LucasLiuXinqi/RUKA-V2-Assembly-Instruction/docs/SUMMARY.md

# Table of contents

* [Home](README.md)
* [Hardware Overview](introduction.md)
* [Bill of Materials](bom.md)
* [CAD Files](cad-files.md)

## Assembly

* [Overview](assembly/index.md)
* [Step 01 — Heat Insert Tutorial](assembly/step-01-palm.md)
* [Step 02 — Finger Assembly](assembly/step-02-fingers.md)
* [Step 03 — Knuckle Assembly](assembly/step-03-tendons.md)
* [Step 04 — Palm Assembly](assembly/step-04-wrist.md)
* [Step 05 — Wrist Assembly](assembly/step-05-final.md)
* [Step 06 — Wiring and Motor IDs](assembly/step-06-wiring-and-motor-ids.md)
* [Step 07 — Motor Base Assembly](assembly/step-07-motor-base-assembly.md)
* [Step 08 — Attach Wrist and Motor Base](assembly/step-08-attach-wrist-and-motor-base.md)
* [Step 09 — Mount Pulleys](assembly/step-09-mount-pulleys.md)
* [Step 10 — Robot Arm Mount](assembly/step-10-robot-arm-mount.md)

## Software

* [Calibration](software/motion-check.md)
