LucasLiuXinqi/RUKA-V2-Assembly-Instruction/docs/cad-files.md

---
icon: file-cad
---

# CAD Files

### Complete CAD File

put link here

### Download and print parts

Plate STLs

<table><thead><tr><th width="259.3046875">Print Setting</th><th>Right Hand</th><th>Left Hand</th></tr></thead><tbody><tr><td>100% infill, 0.2mm layer height</td><td></td><td></td></tr><tr><td>50% infill, 0.2mm layer height</td><td></td><td></td></tr><tr><td>100% infill, 0.2mm layer height</td><td></td><td></td></tr><tr><td>100% infill, 0.2mm layer height</td><td></td><td></td></tr><tr><td>30% infill, 0.2mm layer height</td><td></td><td></td></tr><tr><td>100% infill, 0.2mm layer height</td><td></td><td></td></tr><tr><td>100% infill, 0.2mm layer height</td><td></td><td></td></tr></tbody></table>

### Finger Tip Replacements

| Print Setting | Files |
| --- | --- |
| |  |
| |  |
| |  |
