LucasLiuXinqi/RUKA-V2-Assembly-Instruction/docs/introduction.md

---
icon: robot-astromech
---

# Hardware Overview

### What do I need to buy?

{% content-ref url="bom.md" %}
[bom.md](bom.md)
{% endcontent-ref %}

### What do I need to print?

{% content-ref url="cad-files.md" %}
[cad-files.md](cad-files.md)
{% endcontent-ref %}

### How can I build one?

{% content-ref url="/broken/pages/gg4XZXHeW4K00vUBnZCy" %}
[Broken link](/broken/pages/gg4XZXHeW4K00vUBnZCy)
{% endcontent-ref %}
