LucasLiuXinqi/RUKA-V2-Assembly-Instruction/docs/bom.md

---
icon: sack-dollar
---

# Bill of Materials

<table><thead><tr><th width="252.07421875">Name</th><th>URL</th><th width="100">Quantity</th></tr></thead><tbody><tr><td>Tendons: Braided Fishing Line (0.75mm or 0.68mm)</td><td><a href="https://www.amazon.com/dp/B076HJ3VS5?social_share=cm_sw_r_cp_ud_dp_24VJYD9PYNSQ9QNX9VNS&#x26;previewDoh=1">https://www.amazon.com/dp/B076HJ3VS5?social_share=cm_sw_r_cp_ud_dp_24VJYD9PYNSQ9QNX9VNS&#x26;previewDoh=1</a></td><td>1</td></tr><tr><td>PTFE Tubing 2mm ID, 4mm OD (5 ft)</td><td><a href="https://www.google.com/url?q=https://www.mcmaster.com/52335K32/&#x26;sa=D&#x26;source=editors&#x26;ust=1770211511896520&#x26;usg=AOvVaw31-wdlbmtokcd7ZWvv9eOh">https://www.google.com/url?q=https://www.mcmaster.com/52335K32/&#x26;sa=D&#x26;source=editors&#x26;ust=1770211511896520&#x26;usg=AOvVaw31-wdlbmtokcd7ZWvv9eOh</a></td><td>1</td></tr><tr><td>Bambu Matte Black Filament</td><td><a href="https://www.google.com/url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;sa=D&#x26;source=editors&#x26;ust=1770211511897782&#x26;usg=AOvVaw3Xr1db1b0BrXV-5jqtFpiD">https://www.google.com/url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;sa=D&#x26;source=editors&#x26;ust=1770211511897782&#x26;usg=AOvVaw3Xr1db1b0BrXV-5jqtFpiD</a></td><td>1</td></tr><tr><td>16 mm Dowel Pins (50 pk)</td><td><a href="https://www.google.com/url?q=https://www.mcmaster.com/91585A304/&#x26;sa=D&#x26;source=editors&#x26;ust=1770211511900546&#x26;usg=AOvVaw1xtzFYYHmhV-85Eanl925z">https://www.google.com/url?q=https://www.mcmaster.com/91585A304/&#x26;sa=D&#x26;source=editors&#x26;ust=1770211511900546&#x26;usg=AOvVaw1xtzFYYHmhV-85Eanl925z</a></td><td>1</td></tr><tr><td>M2/3/4/5 Srew Set</td><td><a href="https://www.google.com/url?q=https://a.co/d/elxrhl5&#x26;sa=D&#x26;source=editors&#x26;ust=1770211511901753&#x26;usg=AOvVaw3hGCDJwOGZF84YwLuHKkzG">https://www.google.com/url?q=https://a.co/d/elxrhl5&#x26;sa=D&#x26;source=editors&#x26;ust=1770211511901753&#x26;usg=AOvVaw3hGCDJwOGZF84YwLuHKkzG</a></td><td>1</td></tr><tr><td>Torsion Spring, Left-Hand Wind (6 pk)</td><td><a href="https://www.google.com/url?q=https://www.mcmaster.com/9271K177/&#x26;sa=D&#x26;source=editors&#x26;ust=1770211511902859&#x26;usg=AOvVaw0EKswpu569-A0xXOycgV93">https://www.google.com/url?q=https://www.mcmaster.com/9271K177/&#x26;sa=D&#x26;source=editors&#x26;ust=1770211511902859&#x26;usg=AOvVaw0EKswpu569-A0xXOycgV93</a></td><td>1</td></tr><tr><td>Extension Springs 0.016"x0.16"x0.59" (5 pk)</td><td><a href="https://www.amazon.com/METALLIXITY-Extension-0-4x4x15mm-Stainless-Tension/dp/B0BRHFPGDM?sr=1-1">https://www.amazon.com/METALLIXITY-Extension-0-4x4x15mm-Stainless-Tension/dp/B0BRHFPGDM?sr=1-1</a></td><td>3</td></tr><tr><td>Extension Springs 0.016"x0.16"x0.79" (5 pk)</td><td><a href="https://www.amazon.com/METALLIXITY-Extension-0-4x4x15mm-Stainless-Tension/dp/B0BRHFJ33V?sr=1-1">https://www.amazon.com/METALLIXITY-Extension-0-4x4x15mm-Stainless-Tension/dp/B0BRHFJ33V?sr=1-1</a></td><td>1</td></tr><tr><td>Brass Insert Variety Pack</td><td><a href="https://www.amazon.com/dp/B08YYGRCBG?starsLeft=1">https://www.amazon.com/dp/B08YYGRCBG?starsLeft=1</a></td><td>1</td></tr><tr><td>M2*2 Insert</td><td><a href="https://www.amazon.com/Pofsnnx-Components-Classification-Combination-M2xL2xD3-2/dp/B0FJXLNMLM?sr=1-3">https://www.amazon.com/Pofsnnx-Components-Classification-Combination-M2xL2xD3-2/dp/B0FJXLNMLM?sr=1-3</a></td><td>1</td></tr><tr><td>Bearings 2.5mm Inner Dia 6mm OD 2.6mm</td><td><a href="https://www.amazon.com/uxcell-682XZZ-Groove-Bearings-Shielded/dp/B082PX3KX9?sr=8-8&#x26;th=1">https://www.amazon.com/uxcell-682XZZ-Groove-Bearings-Shielded/dp/B082PX3KX9?sr=8-8&#x26;th=1</a></td><td>4</td></tr><tr><td>Bearings 5mm Inner Dia 10mm OD 4mm</td><td><a href="https://www.amazon.com/uxcell-MR105-2RS-Groove-Bearings-Double/dp/B082PS3QDJ?sr=8-5">https://www.amazon.com/uxcell-MR105-2RS-Groove-Bearings-Double/dp/B082PS3QDJ?sr=8-5</a></td><td>1</td></tr><tr><td>M5 Lock Nuts</td><td><a href="https://www.amazon.com/PDETVEO-50PCS-Stainless-M5-0-8-Insert/dp/B0D8THJQNM?sr=8-7">https://www.amazon.com/PDETVEO-50PCS-Stainless-M5-0-8-Insert/dp/B0D8THJQNM?sr=8-7</a></td><td>1</td></tr><tr><td>DYNAMIXEL XL330-M288-T</td><td><a href="https://www.robotis.us/dynamixel-xl330-m288-t/">https://www.robotis.us/dynamixel-xl330-m288-t/</a></td><td>11</td></tr><tr><td>DYNAMIXEL XM430-W210-R</td><td><a href="https://robotis.us/dynamixel-xm430-w210-r/?searchid=212368&#x26;search_query=XM430">https://robotis.us/dynamixel-xm430-w210-r/?searchid=212368&#x26;search_query=XM430</a></td><td>2</td></tr><tr><td>DYNAMIXEL XL430-W250-T</td><td><a href="https://robotis.us/dynamixel-xl430-w250-t/?searchid=212370&#x26;search_query=XL430">https://robotis.us/dynamixel-xl430-w250-t/?searchid=212370&#x26;search_query=XL430</a></td><td>3</td></tr><tr><td>U2D2</td><td><a href="https://www.google.com/url?q=https://www.robotis.us/u2d2/&#x26;sa=D&#x26;source=editors&#x26;ust=1770211511909171&#x26;usg=AOvVaw3GSwC8QKqZ7f6Z-GA2svD5">https://www.google.com/url?q=https://www.robotis.us/u2d2/&#x26;sa=D&#x26;source=editors&#x26;ust=1770211511909171&#x26;usg=AOvVaw3GSwC8QKqZ7f6Z-GA2svD5</a></td><td>1</td></tr><tr><td>12V 5V Power Supply</td><td></td><td>1</td></tr><tr><td>Power Cable</td><td><a href="https://www.google.com/url?q=https://a.co/d/74DwkBz&#x26;sa=D&#x26;source=editors&#x26;ust=1770211511913021&#x26;usg=AOvVaw0vcJ2DKXe4MsHar7cwwOg-">https://www.google.com/url?q=https://a.co/d/74DwkBz&#x26;sa=D&#x26;source=editors&#x26;ust=1770211511913021&#x26;usg=AOvVaw0vcJ2DKXe4MsHar7cwwOg-</a></td><td>1</td></tr><tr><td>XT60 Connector Pairs</td><td></td><td></td></tr><tr><td></td><td></td><td></td></tr></tbody></table>

### **Required Tools**

* 3D Printer
* Soldering Iron
* Allen Keys (M2, M3, M5)
* Tweezers
* Pliers

### Optional (but suggested) Tools

* Sandpaper
* Drill and drill bits
* Soldering tips for brass inserts
