LucasLiuXinqi/RUKA-V2-Assembly-Instruction/docs/.gitbook/assets/FingertipSocket.stl

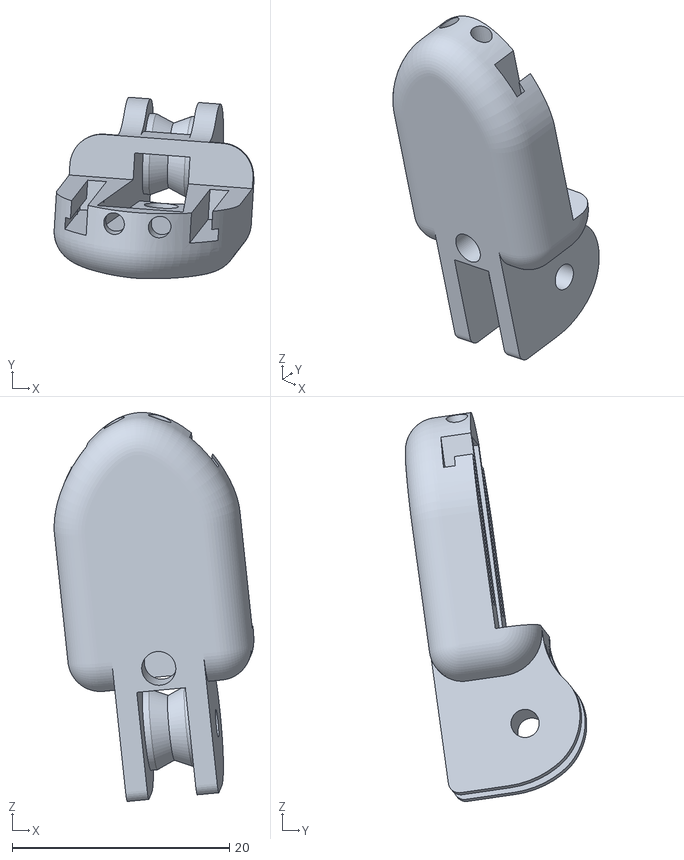
[picture p1: CAD file, 2026-03-08]
docs/.gitbook/assets/FingertipSocket.stl
18.4 x 16.7 x 35.8
