LucasLiuXinqi/RUKA-V2-Assembly-Instruction/docs/.gitbook/assets/AllFingertipButThumb.3mf

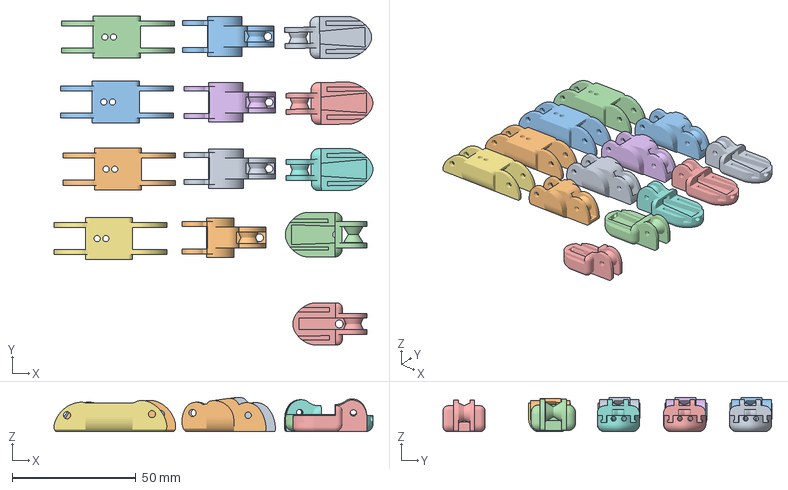
[picture p2: CAD file, 2026-03-08]
docs/.gitbook/assets/AllFingertipButThumb.3mf
129.0 x 133.0 x 13.9 mm
FingertipSocket.stl x 3
RukaV2PinkyPIPTolerance.stl
RukaV2IndexPIPTolerance.stl x 3
RukaV2IndexMCPTolerance.stl x 4
ThumbSocket.stl
PinkySocket.stl
