LucasLiuXinqi/RUKA-V2-Assembly-Instruction/docs/.gitbook/assets/Base_Left.stl

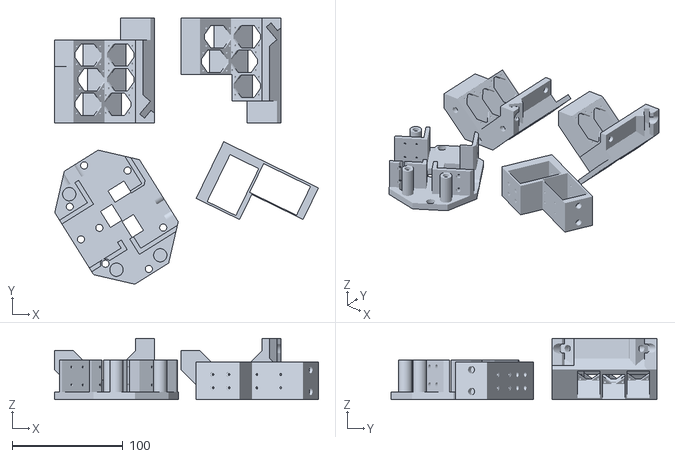
[picture p3: CAD file, 2026-03-03]
docs/.gitbook/assets/Base_Left.stl
237.9 x 240.1 x 55.0
