LucasLiuXinqi/RUKA-V2-Assembly-Instruction/docs/.gitbook/assets/Wrist_Left.stl

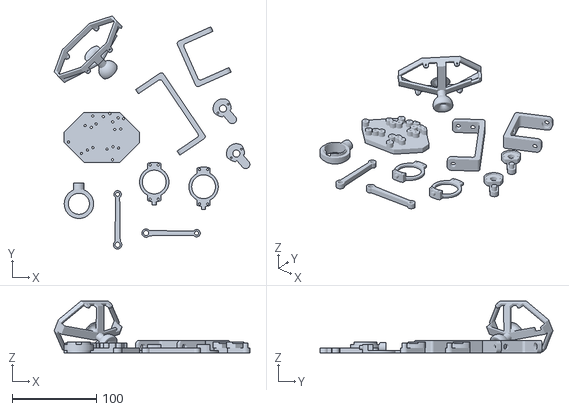
[picture p4: CAD file, 2026-03-03]
docs/.gitbook/assets/Wrist_Left.stl
232.7 x 277.0 x 61.7
