LucasLiuXinqi/RUKA-V2-Assembly-Instruction/docs/.gitbook/assets/Wrist_Base_Left.stl

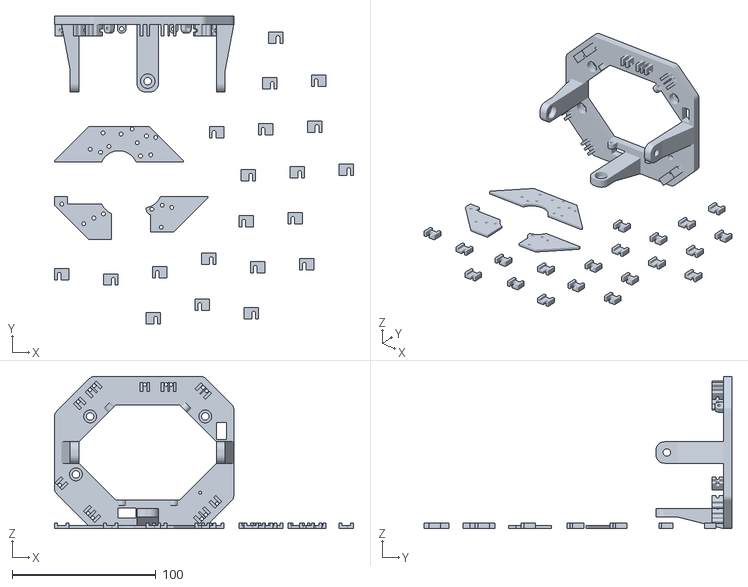
[picture p5: CAD file, 2026-03-03]
docs/.gitbook/assets/Wrist_Base_Left.stl
208.4 x 214.6 x 106.0
