LucasLiuXinqi/RUKA-V2-Assembly-Instruction/docs/.gitbook/assets/Palm_Left.stl

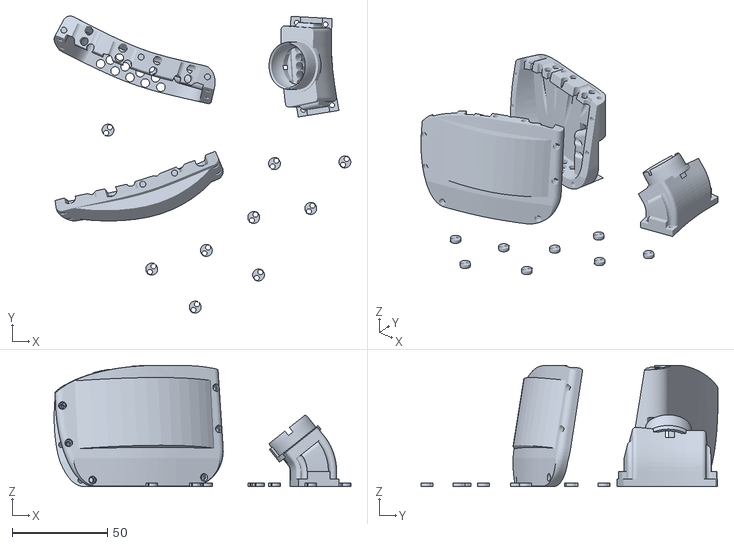
[picture p6: CAD file, 2026-03-03]
docs/.gitbook/assets/Palm_Left.stl
155.5 x 155.6 x 63.5
