LucasLiuXinqi/RUKA-V2-Assembly-Instruction/docs/.gitbook/assets/Arm_Connector (1).stl

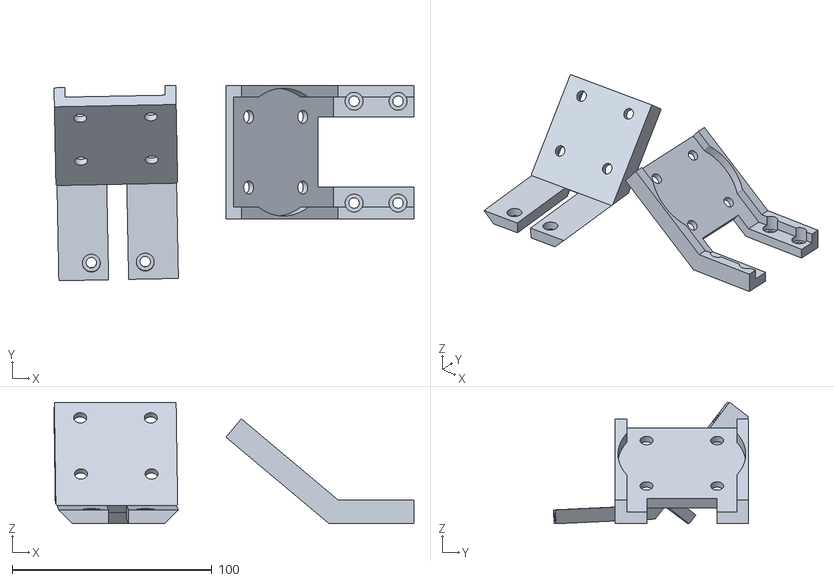
[picture p7: CAD file, 2026-03-03]
docs/.gitbook/assets/Arm_Connector (1).stl
180.3 x 97.9 x 60.8
