LucasLiuXinqi/RUKA-V2-Assembly-Instruction/(list of files, cad)

Other CAD files:
docs/.gitbook/assets/Palm.stl
docs/.gitbook/assets/Wrist_Base.stl
docs/.gitbook/assets/Base.stl
docs/.gitbook/assets/Wrist.stl
