LucasLiuXinqi/RUKA-V2-Assembly-Instruction/docs/assembly/step-09-mount-pulleys.md

# Step 09 — Mount Pulleys

<table><thead><tr><th width="212.91796875">Part Name</th><th width="120.76171875">Quantity</th></tr></thead><tbody><tr><td>Small Pulleys</td><td>11</td></tr><tr><td>Large Pulleys</td><td>3</td></tr><tr><td>6mm Dynamixel screws*</td><td>22</td></tr><tr><td>M2 x 4 mm Screws</td><td>6</td></tr></tbody></table>

\*Screws come with the Dynamixel motors

### Instructions

#### 1. Insert the string

Feed the string through the pulley\


#### 2. Loosely attach the pulley to the motor

Attach the pulley with two screws loosely such that the string can still be pulled\


#### 3. Tie the knot

Tie the knot in the string as close to the pulley as possible, then pull the string through.



#### 4. Tighten the screws all the way

Repeat this for all motors.
