LucasLiuXinqi/RUKA-V2-Assembly-Instruction/docs/assembly/step-10-robot-arm-mount.md

---
description: >-
  There are two different adapter corresponding to two different hand
  orientation.
---

# Step 10 — Robot Arm Mount

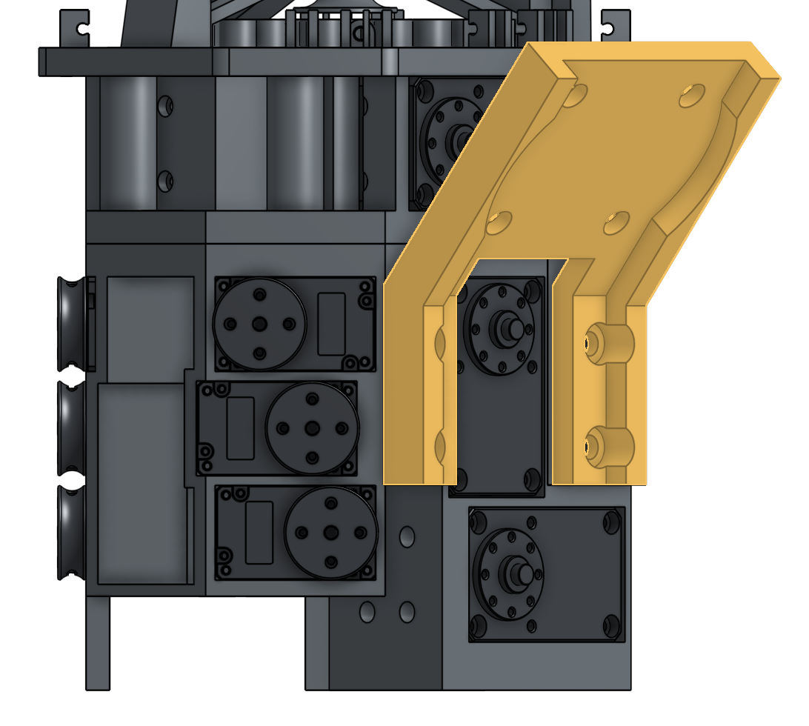
[picture p24: docs/.gitbook/assets/Screenshot 2026-03-25 at 10.56.10.png]
<figure><figcaption></figcaption></figure>

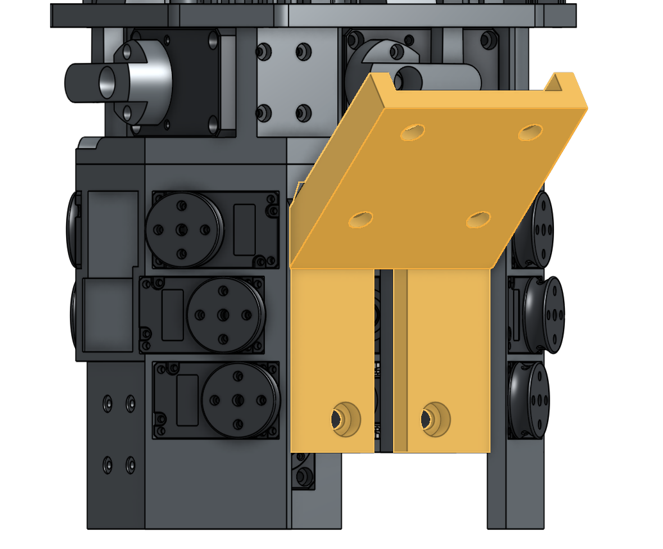
[picture p25: docs/.gitbook/assets/Screenshot 2026-03-25 at 10.56.36.png]
<figure><figcaption></figcaption></figure>
