LucasLiuXinqi/RUKA-V2-Assembly-Instruction/docs/assembly/step-05-final.md

# Step 05 — Wrist Assembly

### 1. Before Assembly

* Make sure that the ball joint is polished, and test it with the wrist connector; it should move freely.

### 2. Assembly Instruction

{% embed url="https://youtu.be/Rm0DyU4A358" %}

#### Bearings Insertion

| Required Parts | Quantity |
| --- | --- |
| Base | 1 |
| Inner Linkage | 1 |
| Outer Linkage | 1 |
| Bearings (10mm OD, 5mm Inner) | 8 |

<mark style="color:$danger;">Suggestion: Use a bench clamp if it is difficult to press in.</mark>

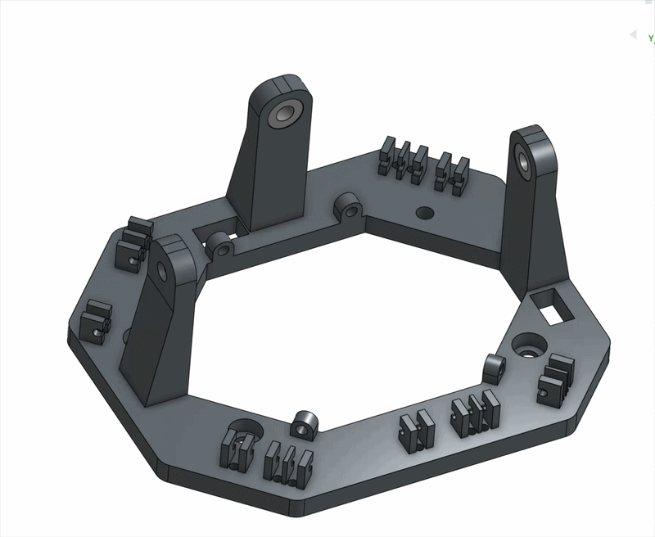
[picture p34: docs/.gitbook/assets/base (1).gif]
<figure><figcaption></figcaption></figure>

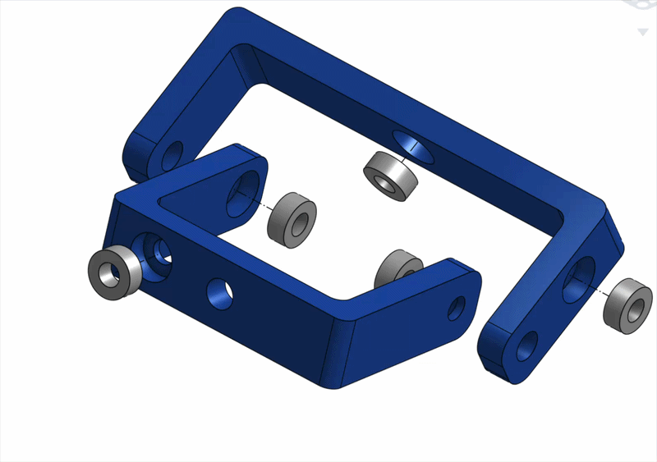
[picture p35: docs/.gitbook/assets/bearing.gif]
<figure><figcaption></figcaption></figure>

#### Wrist Assembly

| Required Parts | Quantity |
| --- | --- |
| Wrist Components | |
| M2 \* 12 Screw | 4 |
| M5 \* 20 Screw | 6 |
| M5 Washer | >8 |
| M5 Lock Nuts | 5 |

1. Press the wrist connector into the inner linkage.&#x20;

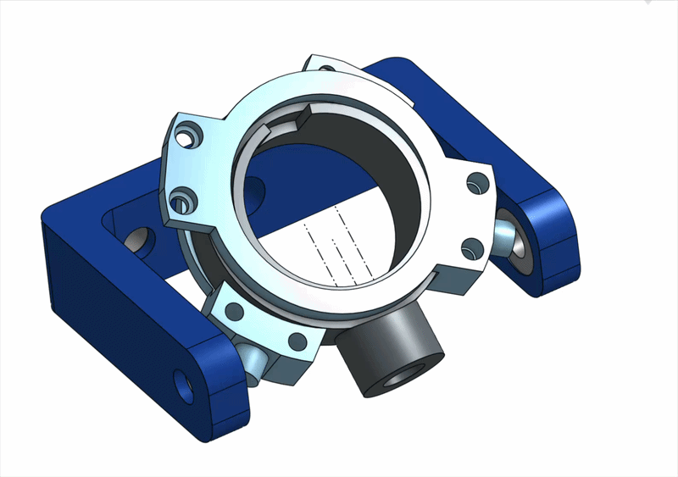
[picture p36: docs/.gitbook/assets/inner.gif]
<figure><figcaption></figcaption></figure>

2. Use four M2 \* 12 screw to fix it. <mark style="color:$danger;">CAUTION: Do not over-tighten the screws; make sure that the grey part moves freely.</mark>&#x20;

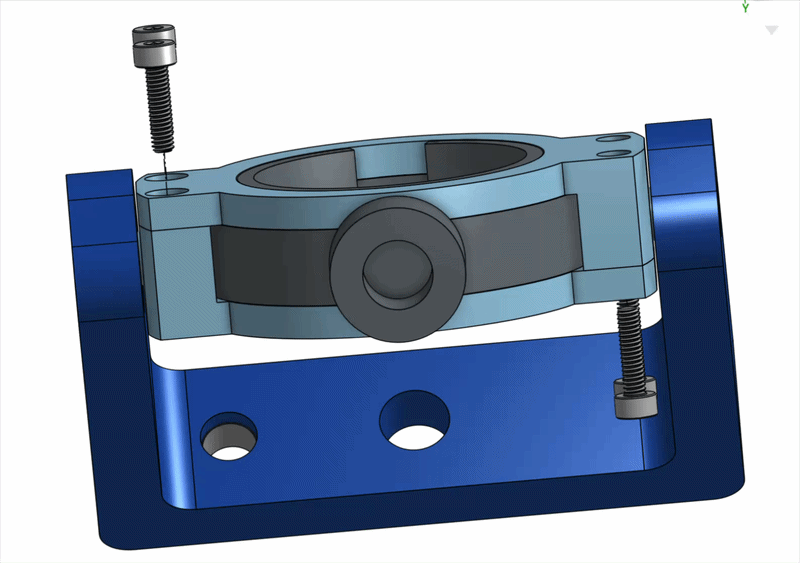
[picture p37: docs/.gitbook/assets/inner_screw.gif]
<figure><figcaption></figcaption></figure>

3. Assemble the wrist as shown below. Please refer to the assembly video for more specific steps.

<mark style="color:$danger;">Please use washers between moving parts.</mark>

<mark style="color:$danger;">Adjust the washer numbers between parts to ensure that the rotation center is at the center of the ball joint.</mark>

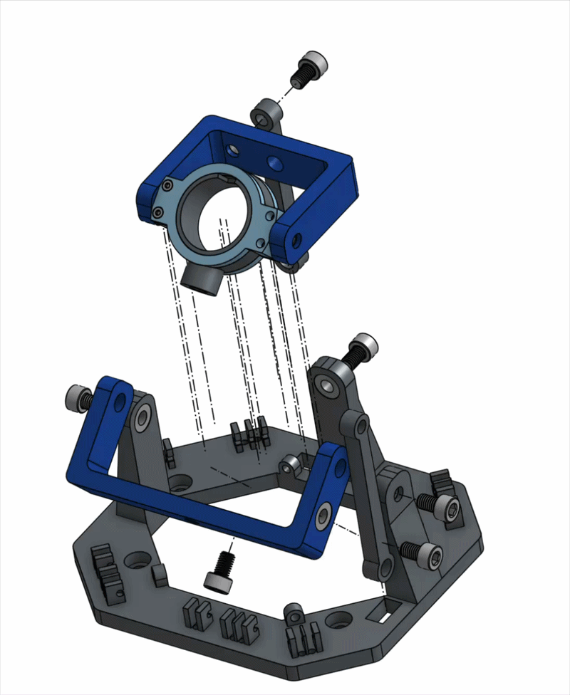
[picture p38: docs/.gitbook/assets/wrist.gif]
<figure><figcaption></figcaption></figure>

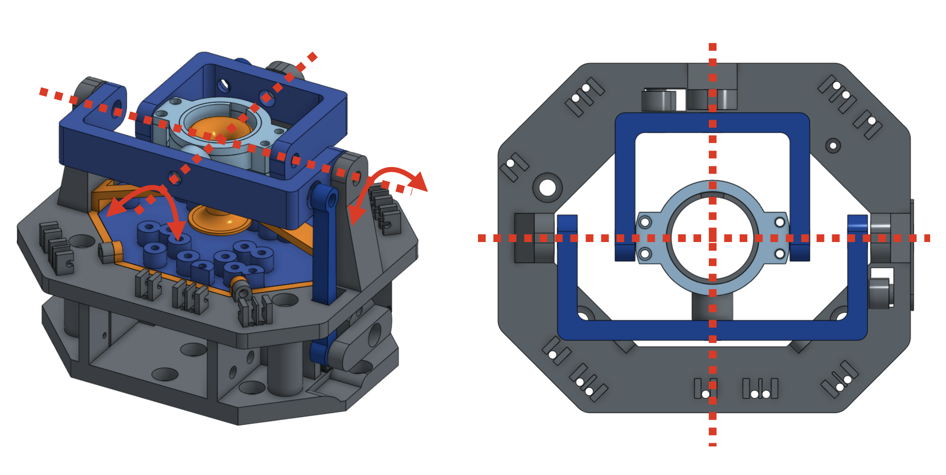
[picture p39: docs/.gitbook/assets/wrist_axis.png]
<figure><figcaption></figcaption></figure>

#### Wrist Routing

{% embed url="https://youtu.be/GrFL19Z3Onc" %}

{% embed url="https://youtu.be/DixnyVoC6T4" %}

Things to Prepare:

* Tape
* Tweezers

<mark style="color:$danger;">Things to Pay Attention:</mark>

* <mark style="color:$danger;">Make sure that the strings are not entangling with each other.</mark>
* &#x20;<mark style="color:$danger;">Verify finger movement after routing.</mark>

Steps:

1. Group and tape the strings at the wrist connector.

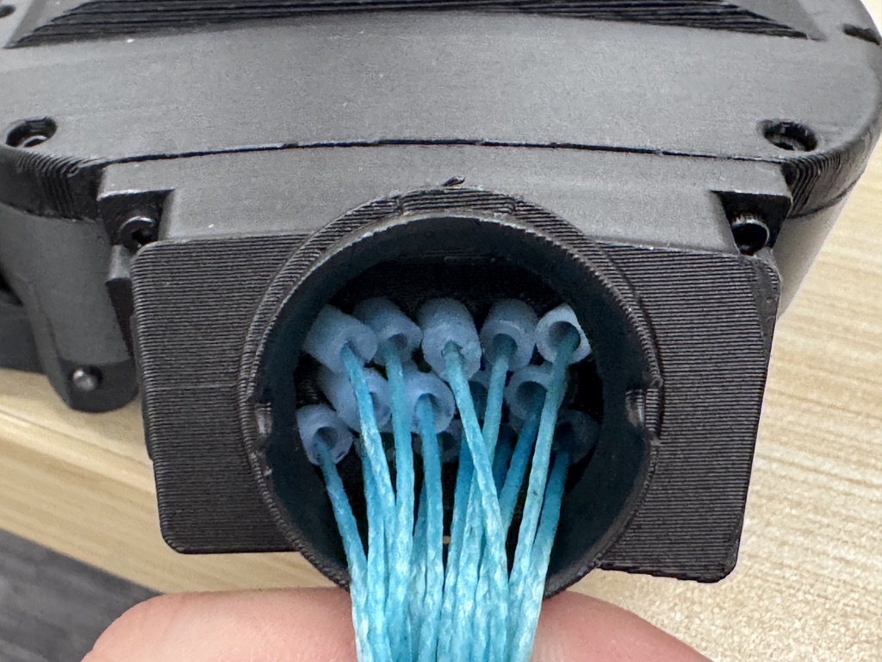
[picture p40: docs/.gitbook/assets/B8E6E3C4-9BB7-40C9-9A20-E2E0F4C1D1F8_1_105_c.jpeg]
<figure><figcaption></figcaption></figure>

2. Route the strings through the wrist group by group, and check for overlapping during the process.

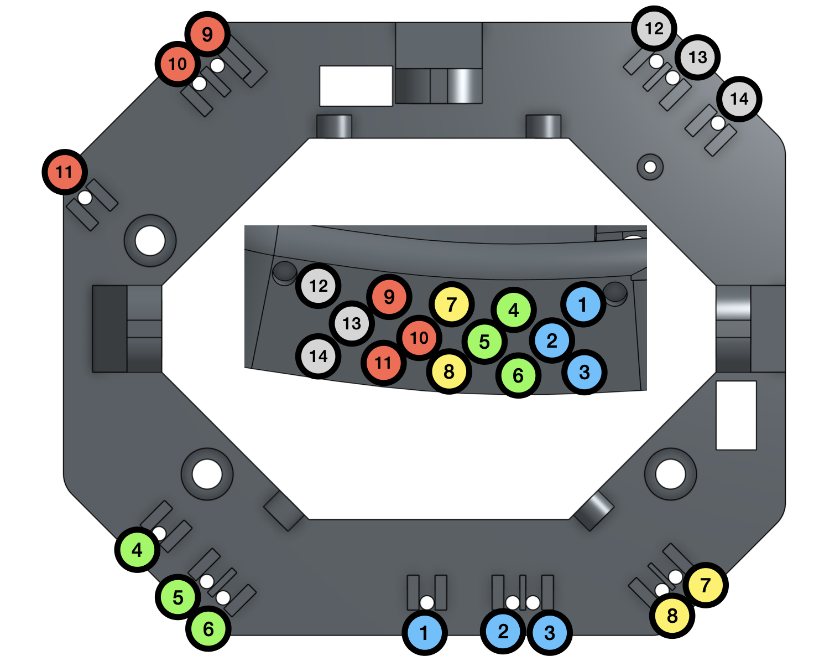
[picture p41: docs/.gitbook/assets/Screenshot 2026-03-04 at 01.11.58.png]
<figure><figcaption></figcaption></figure>

#### Bearing Plate

The printer setting may affect the dowel hole size. If you find it is extremely difficult to insert the dowel, please try re-printing the plate with a larger layer height, or use a 2.5mm drill to enlarge the hole.&#x20;

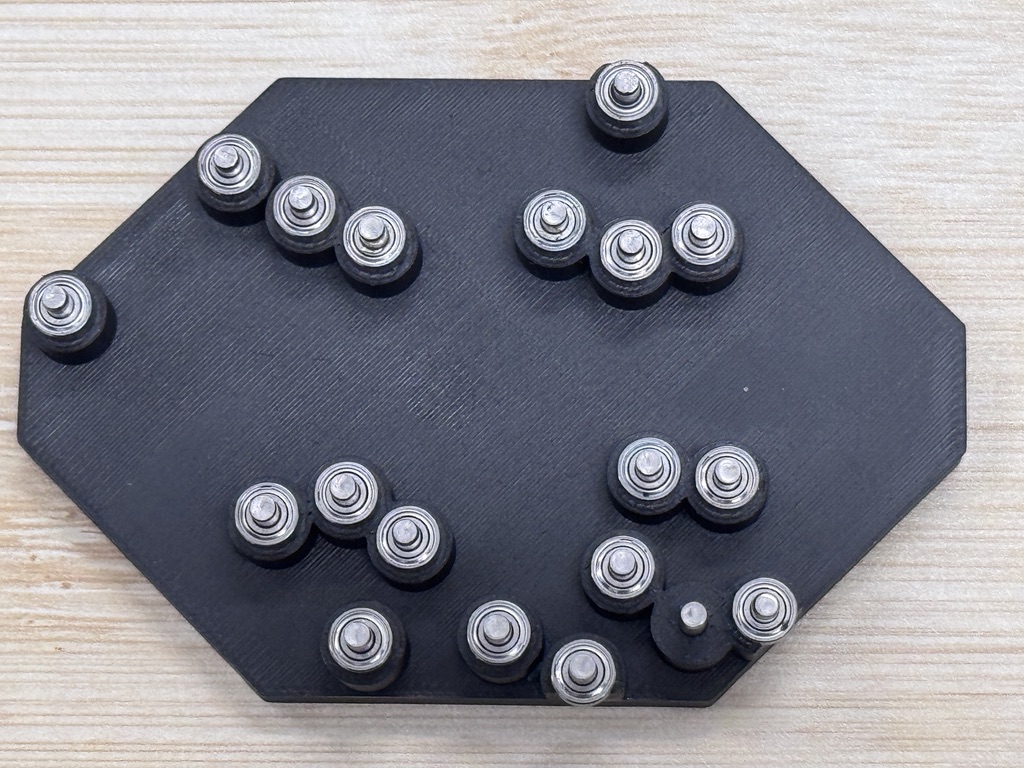
[picture p42: docs/.gitbook/assets/7B8C6E87-BC91-46EE-A5E5-320FA5DCD4B7_1_105_c.jpeg]
<figure><figcaption></figcaption></figure>

{% embed url="https://youtu.be/YHv7OPIKRvE" %}

| Ring Finger Plate | Thumb + Middle + Index | Pinky |
| --- | --- | --- |
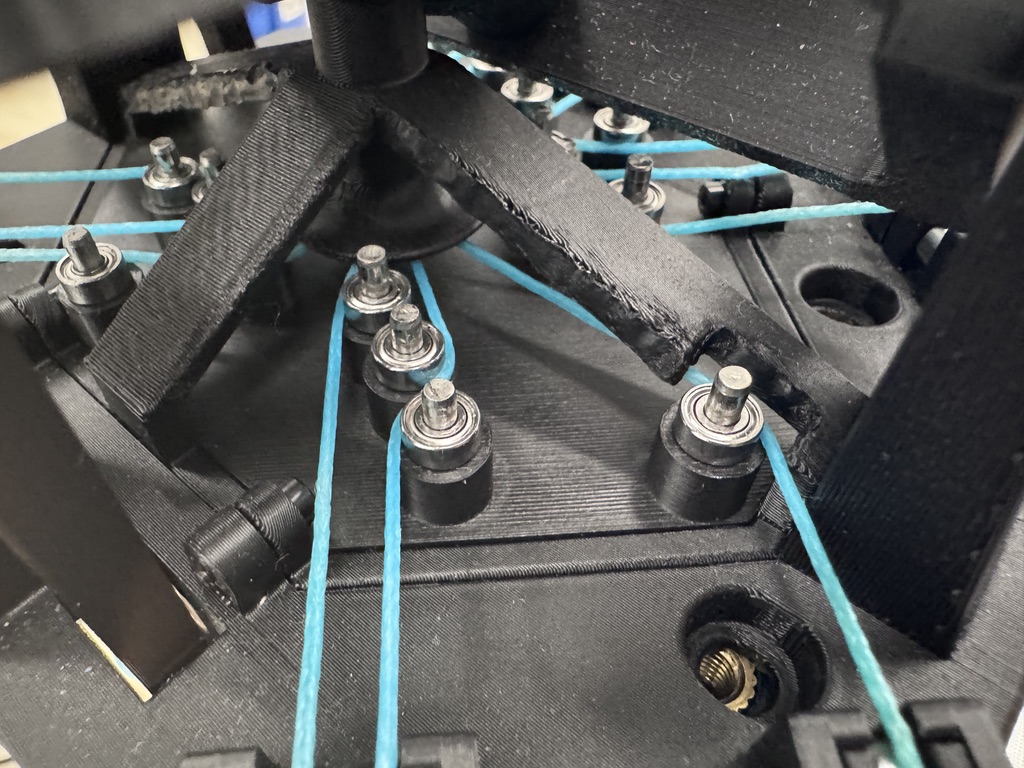
[picture p43: docs/.gitbook/assets/151A4A15-2B52-45D9-B8B3-14B13A85DD86_1_105_c (1).jpeg]
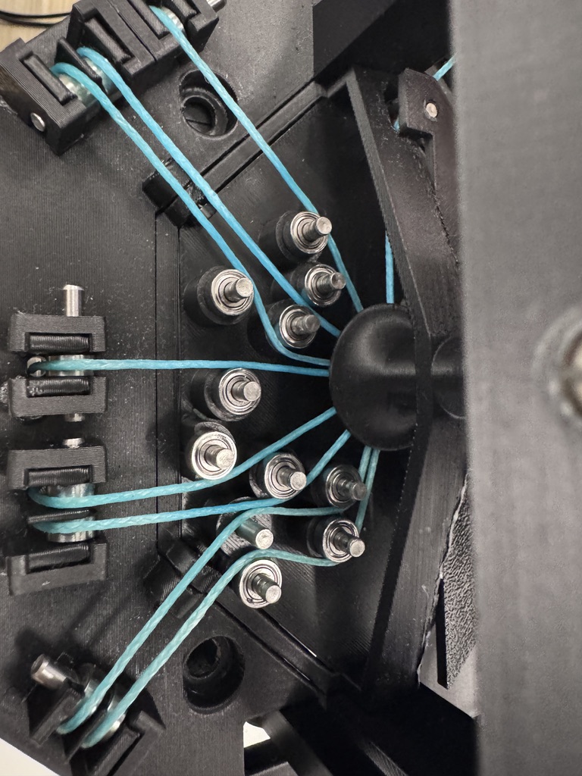
[picture p44: docs/.gitbook/assets/8C3C864C-D76F-4D1B-A166-53389E9B303A_1_105_c.jpeg]
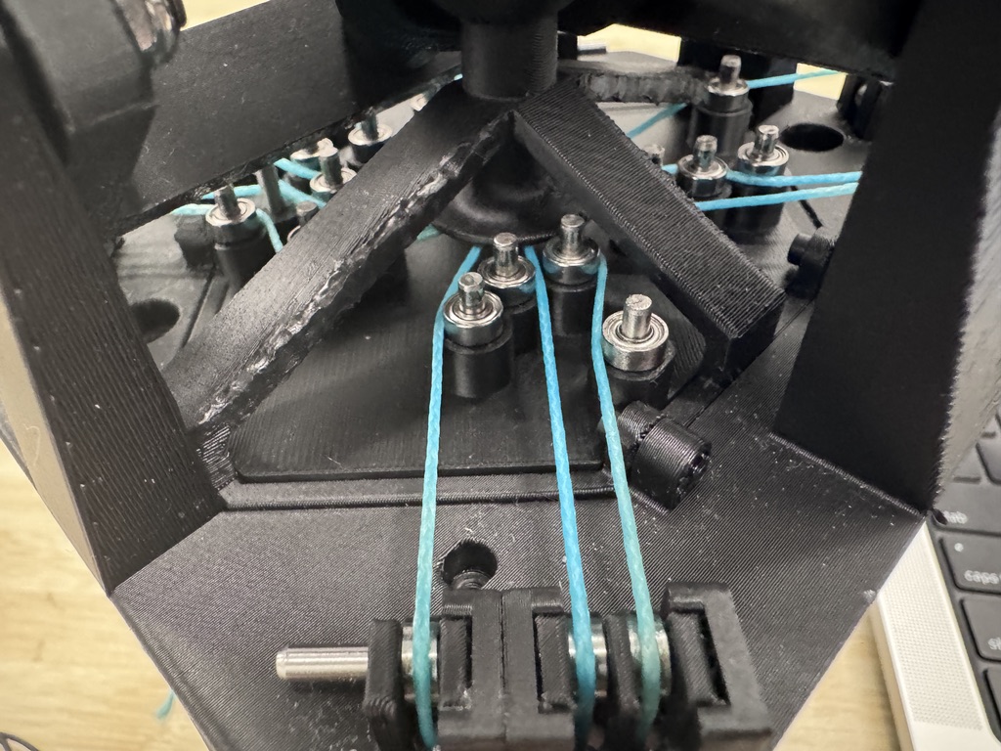
[picture p45: docs/.gitbook/assets/AB6C4F3F-D8A5-42CD-962A-B9747D47DD46_1_105_c.jpeg]
|  |  |  |
