LucasLiuXinqi/RUKA-V2-Assembly-Instruction/docs/assembly/step-08-attach-wrist-and-motor-base.md

# Step 08 — Attach Wrist and Motor Base

{% embed url="https://youtu.be/ohgPTIyYKmM" %}

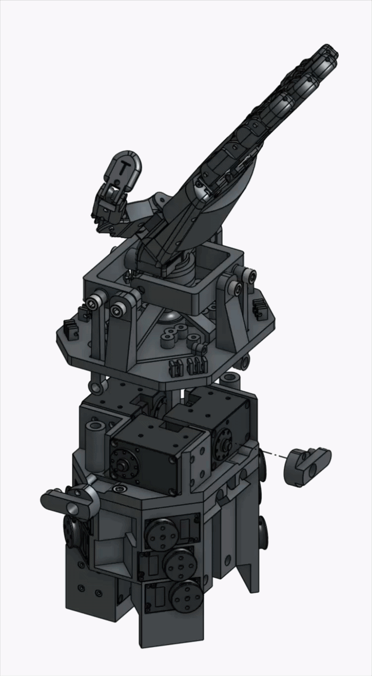
[picture p48: docs/.gitbook/assets/ScreenRecording2026-03-25at10.35.49-ezgif.com-video-to-gif-converter.gif]
<figure><figcaption></figcaption></figure>
