LucasLiuXinqi/RUKA-V2-Assembly-Instruction/docs/assembly/step-01-palm.md

# Step 01 — Heat Insert Tutorial

### Tutorials for Heat Set Inserts

In addition to the video instructions, using a razor blade to push the heat-set insert in for the last millimeter or so is helpful. This ensures it is flush with the surface.

{% embed url="https://youtu.be/P7nHyI1TwKY" %}

### Materials

#### Tools

* Soldering Iron
* Soldering Tips
* Razor Blade

#### 3D Printed Parts

Please prepare all the 3D printed parts, almost all of which will be used in this section

#### Hardware (Inserts)

<table><thead><tr><th width="202.56640625">Part Name</th><th width="144.5703125">Total Quantity</th></tr></thead><tbody><tr><td>M2 x 2 x 3.5 mm insert</td><td>11</td></tr><tr><td>M2 x 4 x 3.5 mm insert</td><td>40</td></tr><tr><td>M2 x 6 x 3.5 mm insert</td><td>6</td></tr><tr><td>M3 x 4 x 5 mm insert</td><td>1</td></tr><tr><td>M5 x 6 x 7 mm insert</td><td>23</td></tr></tbody></table>

### Instructions

#### 1. Fingers (Index, Middle, Ring)

<table><thead><tr><th width="243.015625">Part Name</th><th width="223.03515625">Quantity</th></tr></thead><tbody><tr><td>M2 x 2 x 3.5 Heat Set Inserts</td><td>2 * 3</td></tr><tr><td>M2 x 4 x 3.5 Heat Set Inserts</td><td>3 * 3</td></tr></tbody></table>

| Joint 1 | Joint 2 | Joint 3 |
| --- | --- | --- |
| \[1] M2 x 4 x 3.5 | \[2] M2 x 2 x 3.5 | \[2] M2 x 4 x 3.5 |
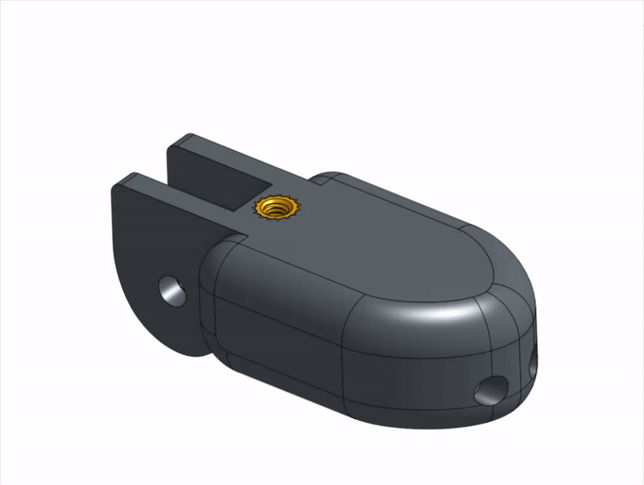
[picture p52: docs/.gitbook/assets/joint1.gif]
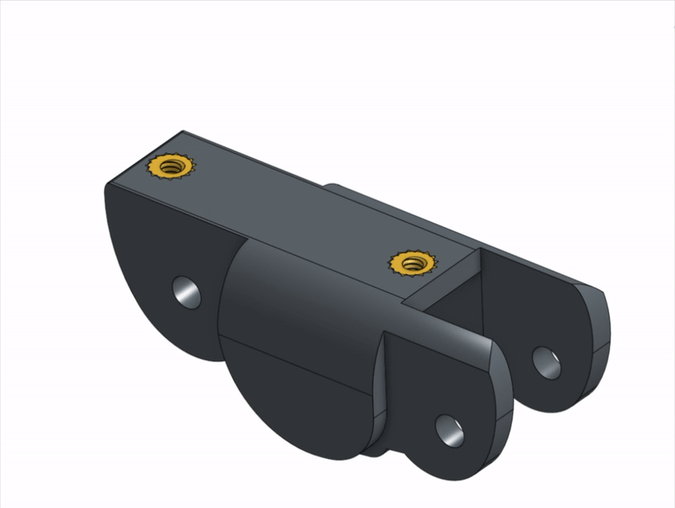
[picture p53: docs/.gitbook/assets/joint2.gif]
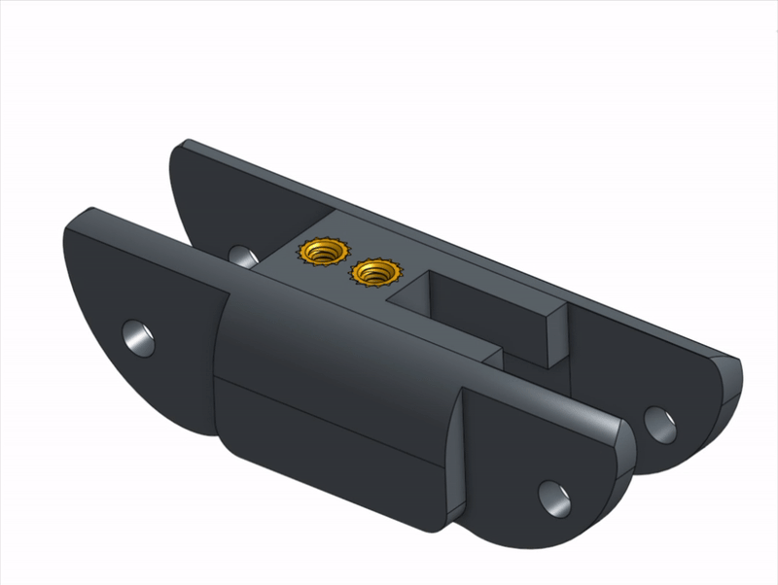
[picture p54: docs/.gitbook/assets/joint3.gif]
|  |  |  |

#### 2. Pinky

<table><thead><tr><th width="243.015625">Part Name</th><th width="223.03515625">Quantity</th></tr></thead><tbody><tr><td>M2 x 2 x 3.5 Heat Set Inserts</td><td>2</td></tr><tr><td>M2 x 4 x 3.5 Heat Set Inserts</td><td>3</td></tr></tbody></table>

| Joint 1 | Joint 2 | Joint 3 |
| --- | --- | --- |
| \[1] M2 x 4 x 3.5 | \[2] M2 x 2 x 3.5 | \[2] M2 x 4 x 3.5 |
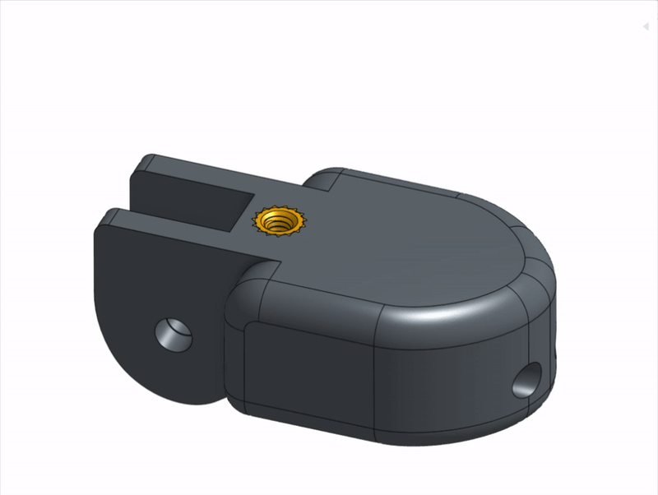
[picture p55: docs/.gitbook/assets/joint1 (1).gif]
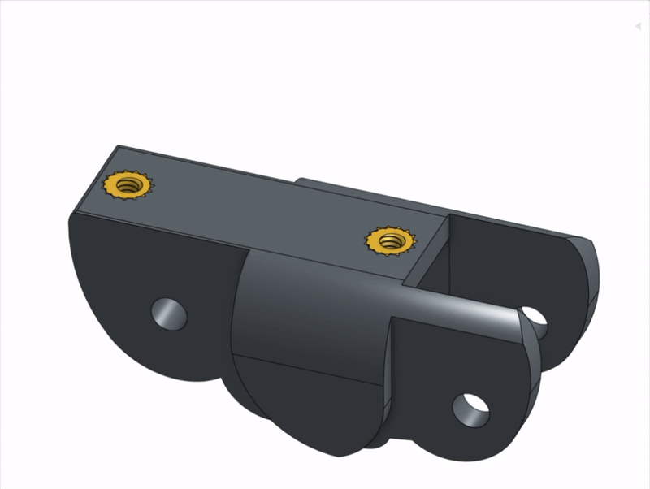
[picture p56: docs/.gitbook/assets/joint2 (1).gif]
|  |  |  |

#### 3. Thumb

<table><thead><tr><th width="243.015625">Part Name</th><th width="223.03515625">Quantity</th></tr></thead><tbody><tr><td>M2 x 4 x 3.5 Heat Set Inserts</td><td>4</td></tr><tr><td>M3 x 4 x 5 Heat Set Inserts</td><td>1</td></tr></tbody></table>

| Joint1 | Joint2 | Joint3 |
| --- | --- | --- |
| \[1] M2 x 4 x 3.5 | \[2] M2 x 4 x 3.5 | <p>[1] M3 x 4 x 5, <br>[1] M2 x 4 x 3.5</p> |
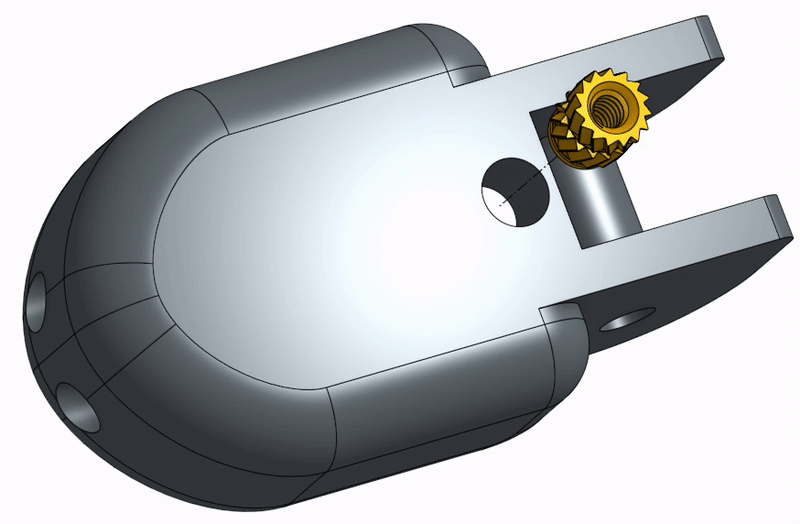
[picture p57: docs/.gitbook/assets/tip.gif]
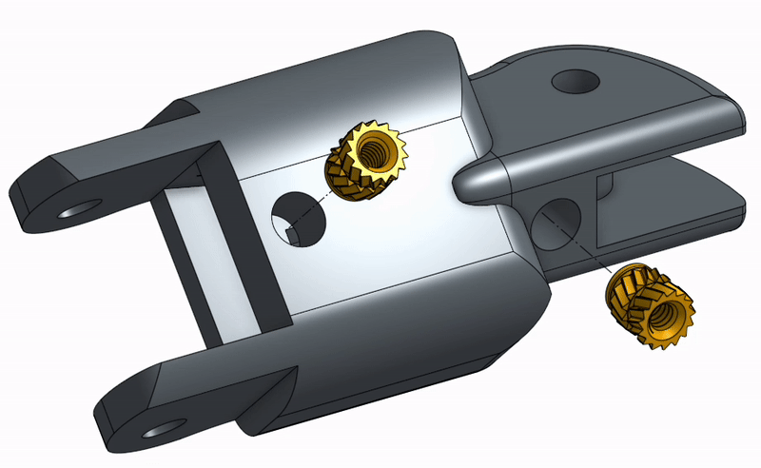
[picture p58: docs/.gitbook/assets/mid.gif]
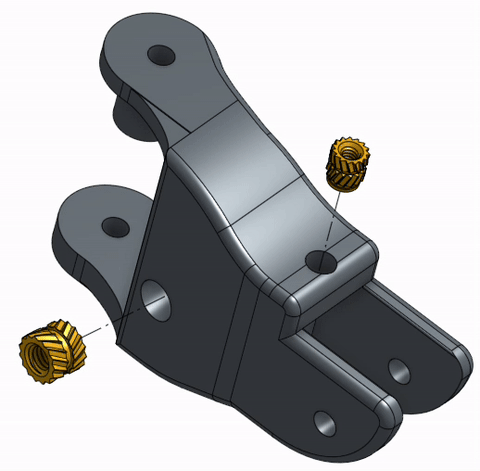
[picture p59: docs/.gitbook/assets/image (2).gif]
|  |  |  |

#### 4. Knuckle

<table><thead><tr><th width="243.015625">Part Name</th><th width="223.03515625">Quantity</th></tr></thead><tbody><tr><td>M2 x 2 x 3.5 Heat Set Inserts</td><td>3</td></tr><tr><td>M2 x 4 x 3.5 Heat Set Inserts</td><td>4</td></tr></tbody></table>

| Index | Ring & Pinky | Middle |
| --- | --- | --- |
| <p>[1] M2 x 2 x 3.5, <br>[1] M2 x 4 x 3.5</p> | <p>[1] M2 x 2 x 3.5, <br>[1] M2 x 4 x 3.5</p> | \[1] M2 x 4 x 3.5 |
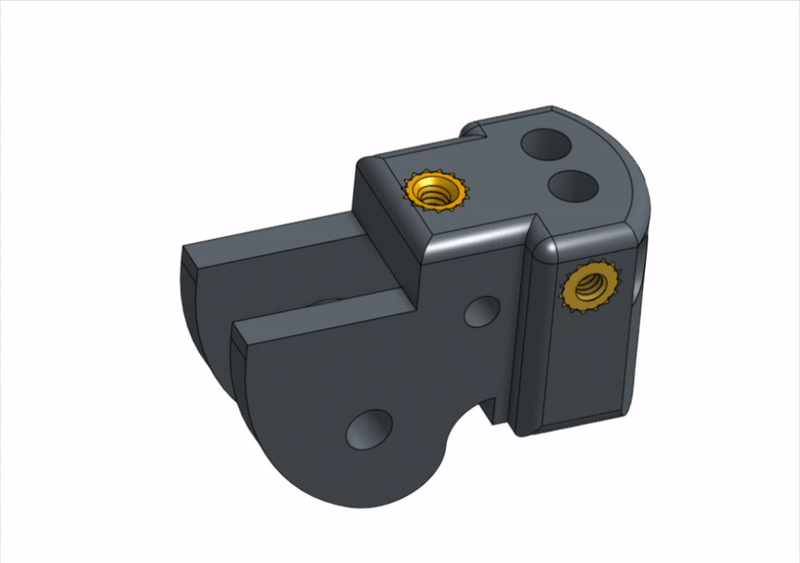
[picture p60: docs/.gitbook/assets/index (1).gif]
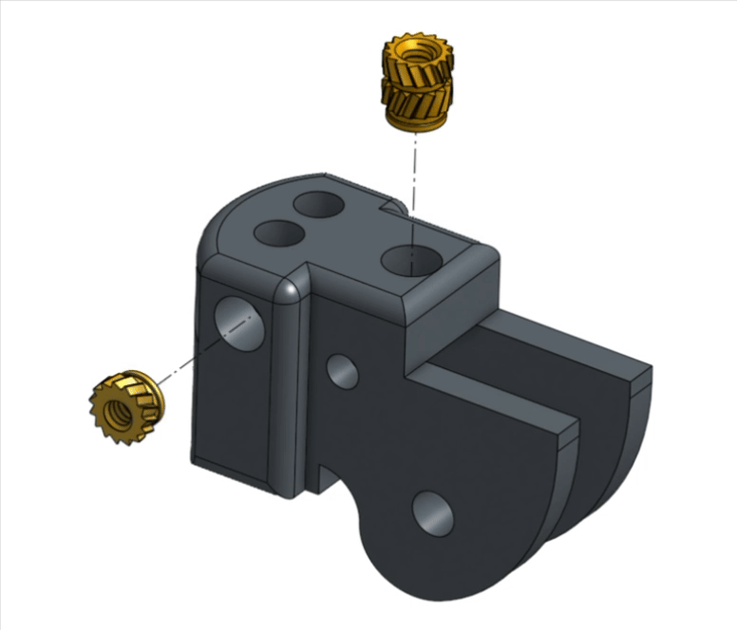
[picture p61: docs/.gitbook/assets/ring (1).gif]
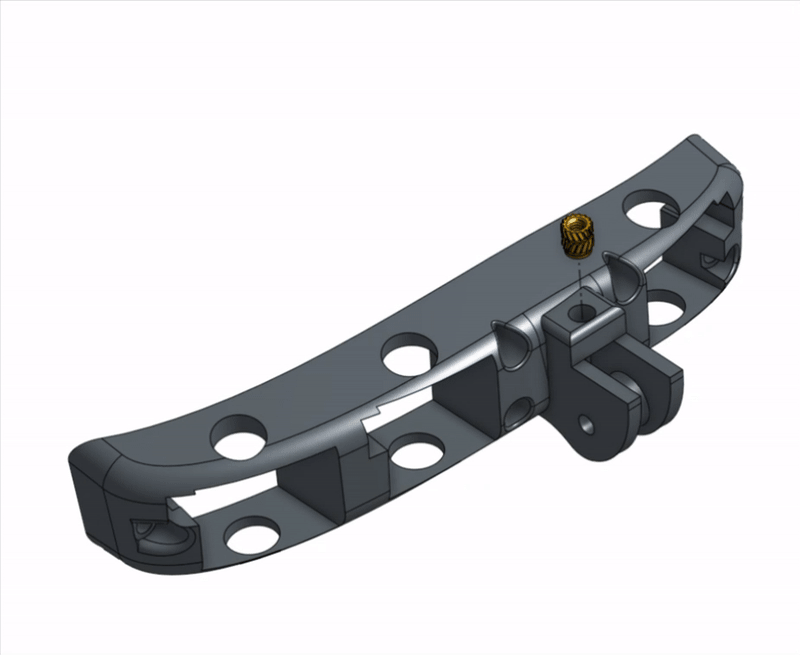
[picture p62: docs/.gitbook/assets/knuckle.gif]
|  |  |  |

#### 5. Palm & Backhand

<table><thead><tr><th width="243.015625">Part Name</th><th width="223.03515625">Quantity</th></tr></thead><tbody><tr><td>M2 x 4 x 3.5 Heat Set Inserts</td><td>12</td></tr><tr><td>M2 x 6 x 3.5 Heat Set Inserts</td><td>6</td></tr></tbody></table>

| Front | Back | Inside |
| --- | --- | --- |
| \[2] M2 x 4 x 3.5 | \[2] M2 x 4 x 3.5 | \[3] M2 x 4 x 3.5 |
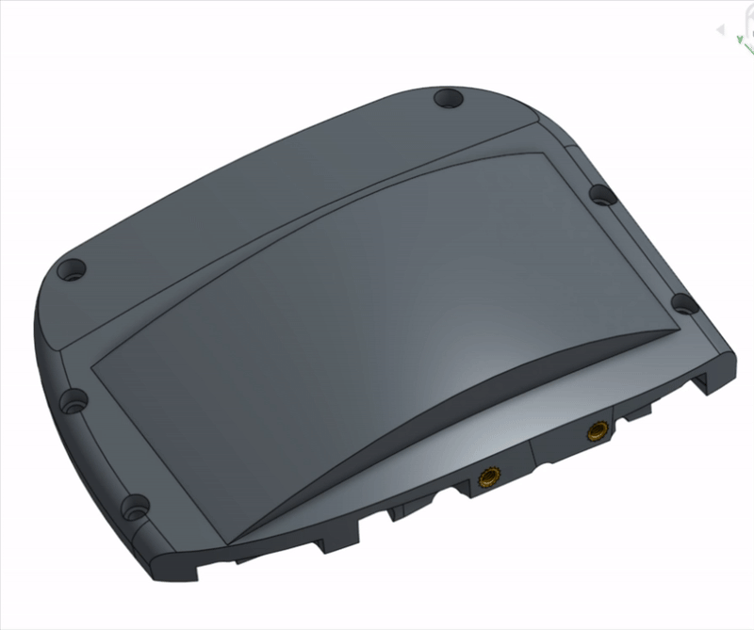
[picture p63: docs/.gitbook/assets/back_front.gif]
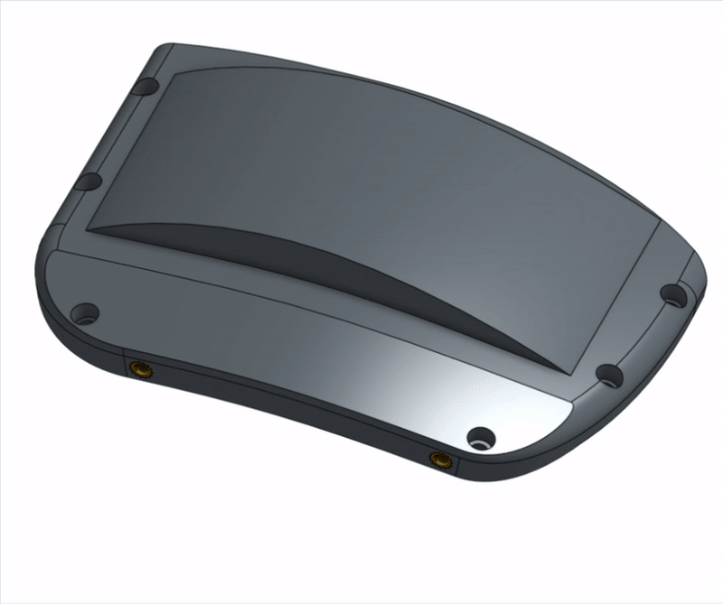
[picture p64: docs/.gitbook/assets/back_back.gif]
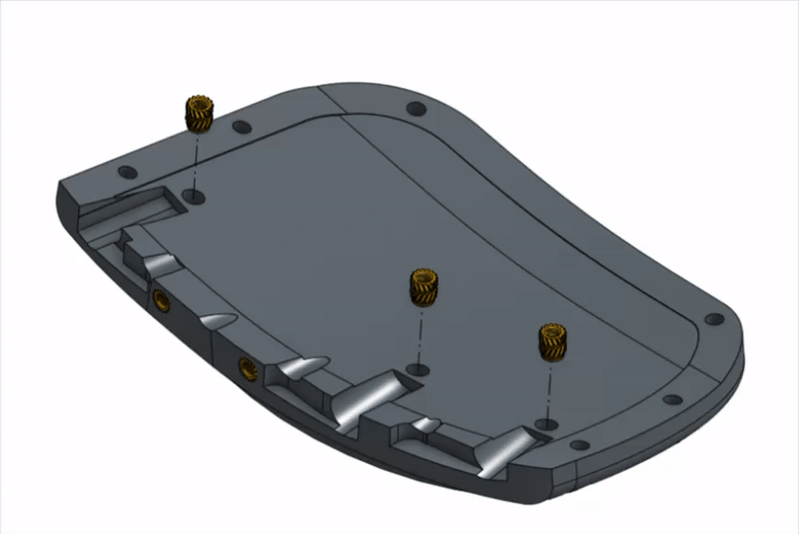
[picture p65: docs/.gitbook/assets/back_in.gif]
|  |  |  |

| Front | Back | Inside |
| --- | --- | --- |
| \[3] M2 x 4 x 3.5 | \[2] M2 x 4 x 3.5 | \[6] M2 x 6 x 3.5 |
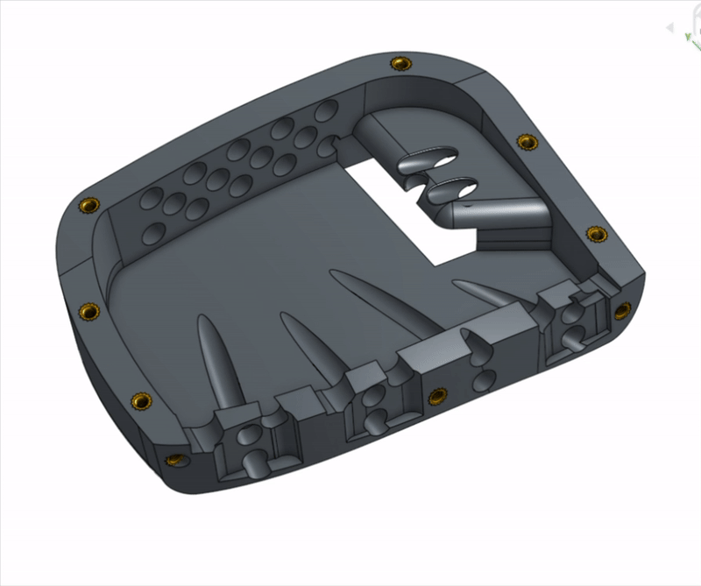
[picture p66: docs/.gitbook/assets/front_front.gif]
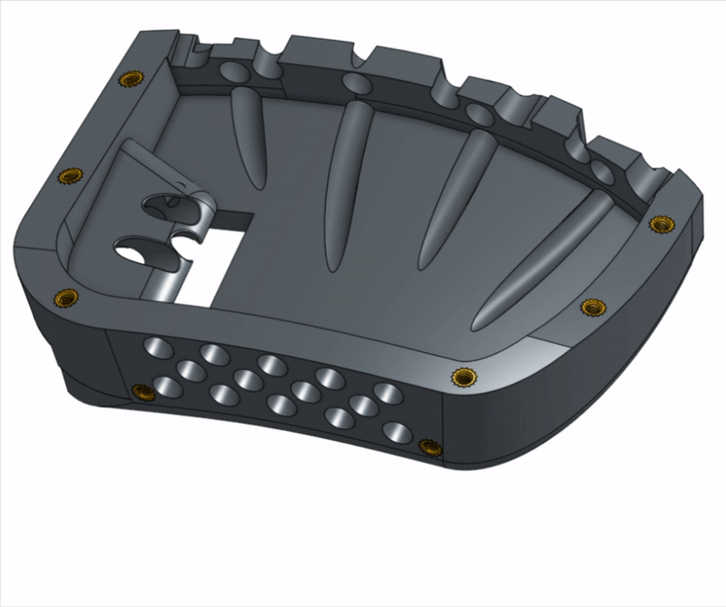
[picture p67: docs/.gitbook/assets/front_back.gif]
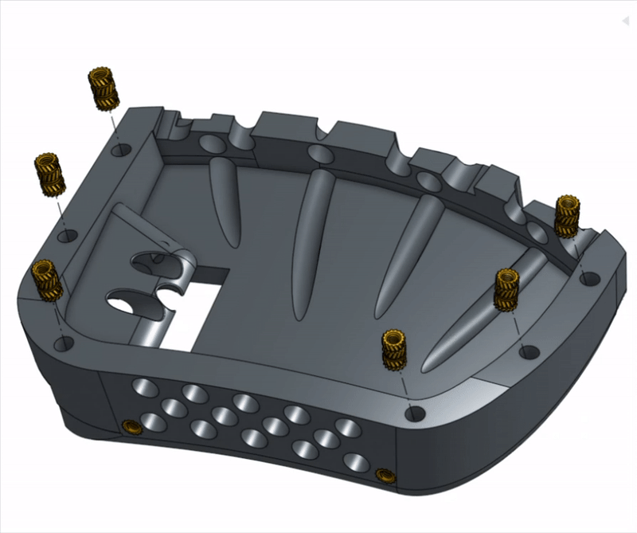
[picture p68: docs/.gitbook/assets/front_up.gif]
|  |  |  |

#### 6. Wrist

<table><thead><tr><th width="243.015625">Part Name</th><th width="223.03515625">Quantity</th></tr></thead><tbody><tr><td>M5 x 6 x 7 Heat Set Inserts</td><td>4</td></tr><tr><td>M2 x 4 x 3.5 Heat Set Inserts</td><td>8</td></tr></tbody></table>

Wrist Connector

| Top & Bottom | Middle |
| --- | --- |
| \[2] M2 x 4 x 3.5 | \[1] M5 x 6 x 7 |
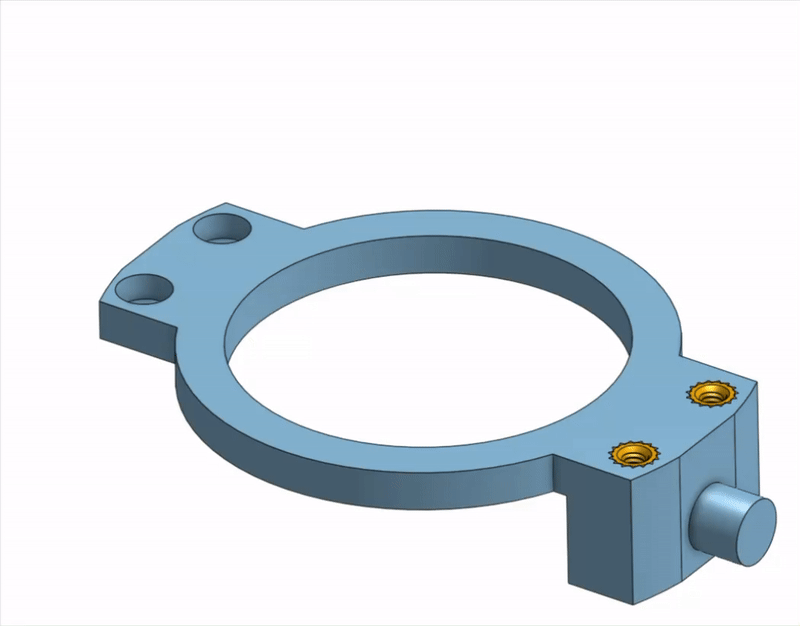
[picture p69: docs/.gitbook/assets/connector (1).gif]
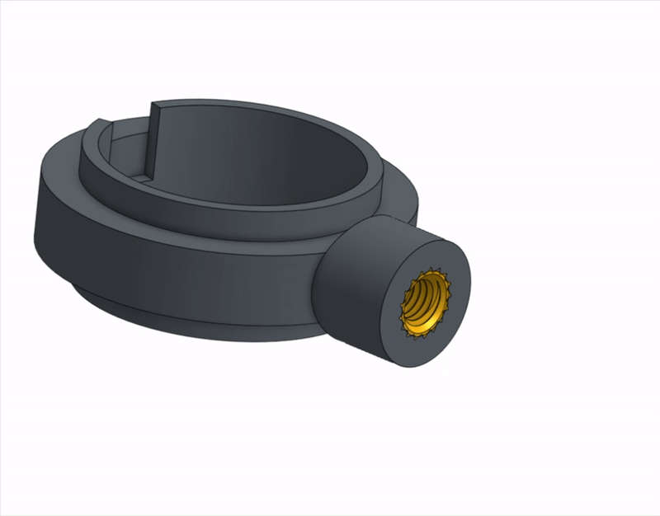
[picture p70: docs/.gitbook/assets/middle (1).gif]
|  |  |

Wrist Base

| Wrist Linkage | Wrist Base |
| --- | --- |
| \[3] M5 x 6 x 7 | \[4] M2 x 4 x 3.5 |
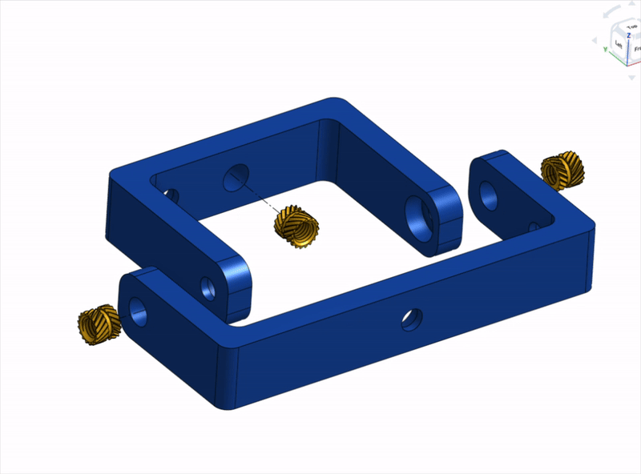
[picture p71: docs/.gitbook/assets/link.gif]
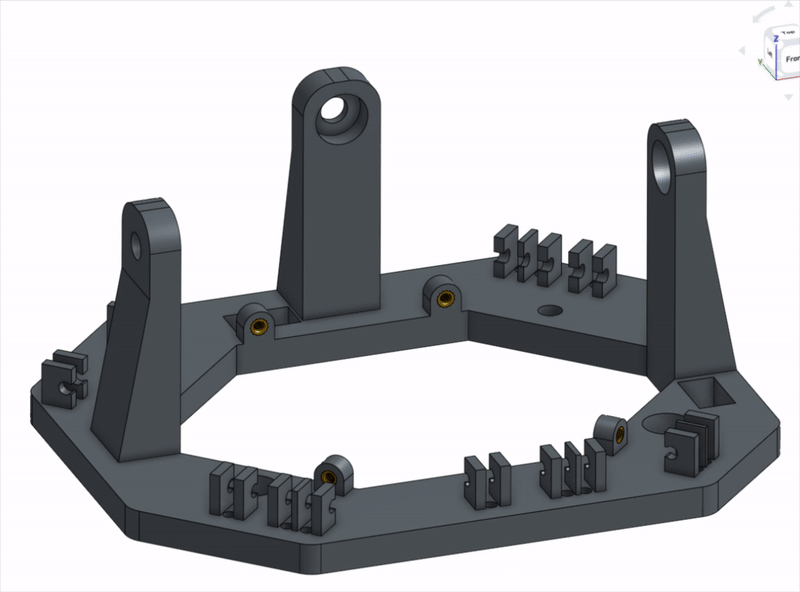
[picture p72: docs/.gitbook/assets/base.gif]
|  |  |

#### 7. Top Motor Panel

<table><thead><tr><th width="243.015625">Part Name</th><th width="223.03515625">Quantity</th></tr></thead><tbody><tr><td>M5 x 6 x 7 Heat Set Inserts</td><td>3</td></tr></tbody></table>

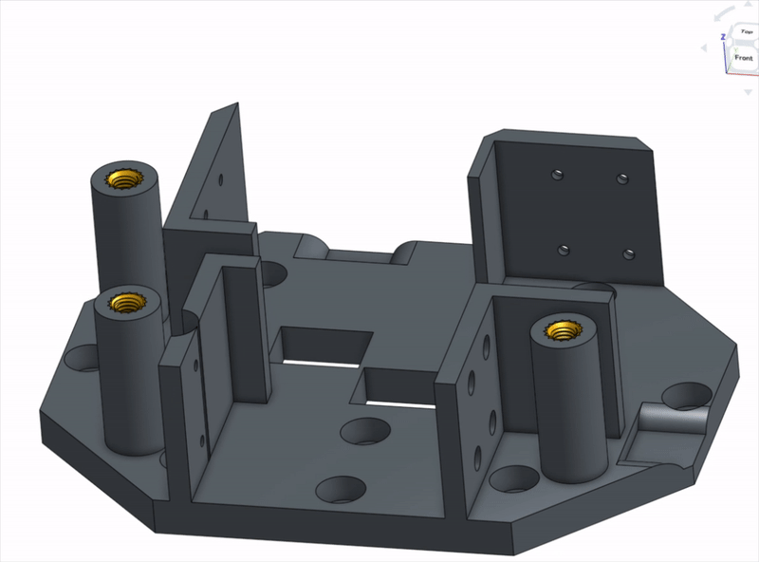
[picture p73: docs/.gitbook/assets/top.gif]
<table><thead><tr><th width="343.33984375">Top Panel</th></tr></thead><tbody><tr><td>[3] M5 x 6 x 7</td></tr><tr><td></td></tr></tbody></table>

#### 8. Motor Base

<table><thead><tr><th width="243.015625">Part Name</th><th width="223.03515625">Quantity</th></tr></thead><tbody><tr><td>M5 x 6 x 7 Heat Set Inserts</td><td>16</td></tr></tbody></table>

| | | |
| --- | --- | --- |
| \[2] M5 x 6 x 7 | \[5] M5 x 6 x 7 | \[2] M5 x 6 x 7 |
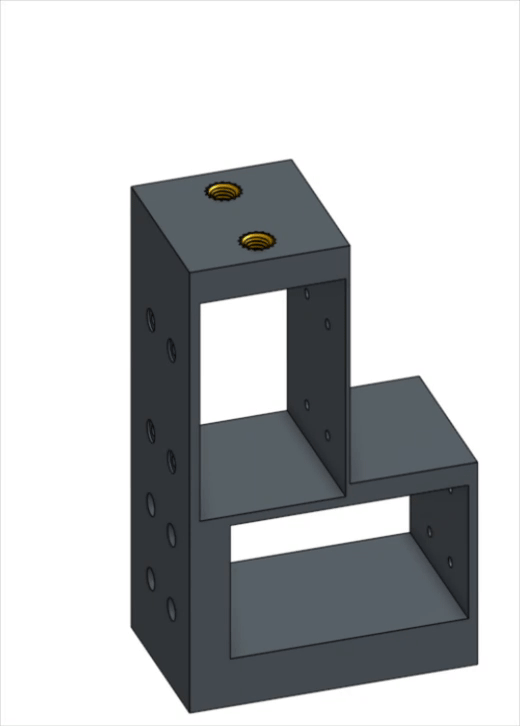
[picture p74: docs/.gitbook/assets/thumb.gif]
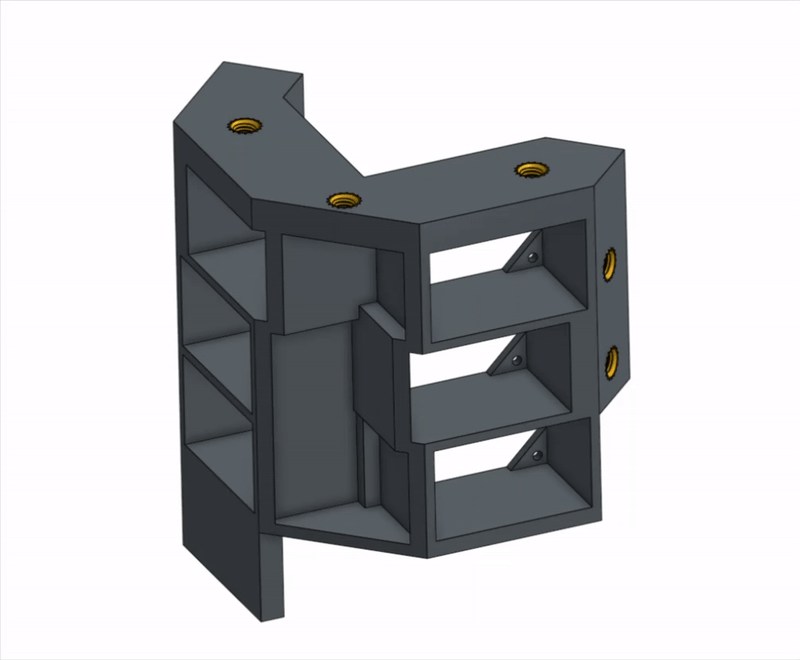
[picture p75: docs/.gitbook/assets/6.gif]
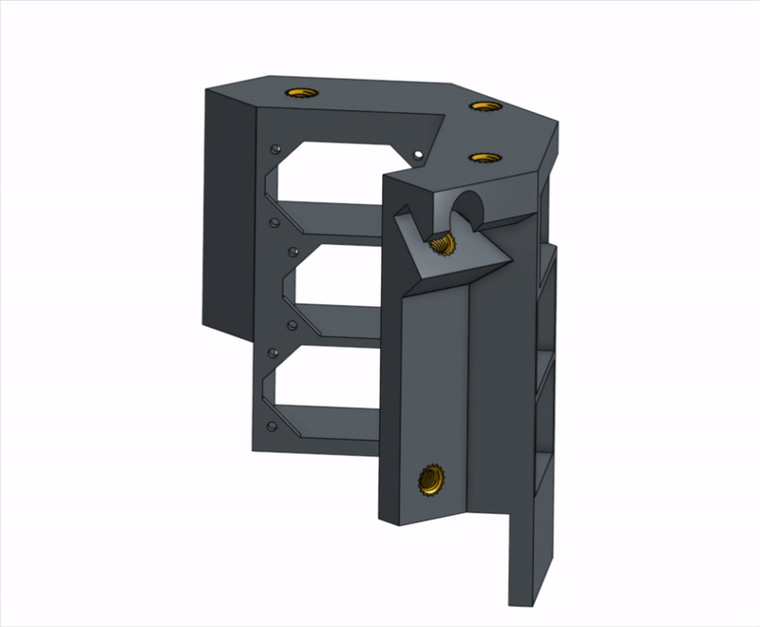
[picture p76: docs/.gitbook/assets/connect.gif]
|  |  |  |
