LucasLiuXinqi/RUKA-V2-Assembly-Instruction/(commit log)

2026-03-03 GITBOOK-24: No subject
    [Arm_Connector.stl, Base.stl, Palm.stl, Wrist.stl, Wrist_Base.stl]
2026-03-03 GITBOOK-26: No subject
    [Arm_Connector (1).stl, Base_Left.stl, Palm_Left.stl, Wrist_Base_Left.stl, Wrist_Left.stl]
2026-03-08 GITBOOK-28: No subject
    [AllFingertipButThumb.3mf, FingertipSocket.stl]
